icl-rocketry/Ricardo-Pete/Hardware/README.md

# Ricardo-BoardTemplate
Board template including the required components for an ESP32S3 as well as CAN and USB. This is the bare minimum needed for boards in the ricardo ecosystem. To use, place the Ricardo-BoardTemplate folder in your KiCad user templates folder. 
By default, this folder is:
Windows - %USERPROFILE%/Documents/KiCad/6.0/template
