icl-rocketry/Ricardo-Pete/(commit log)

2023-08-17 PCB Done
    [PETE.kicad_pcb, PETE.kicad_sch, power.kicad_sch, pressure-sensor.kicad_sch]
2023-08-19 Review Changes Made (except for meme)
    [PETE.kicad_pcb, PETE.kicad_sch, pressure-sensor.kicad_sch]
2023-08-20 Review Changes
    Still don't know whats going on with the overlapping pours. Meme is a bit rubbish but it'll do for now.
    [PETE.kicad_pcb]
2023-08-23 artem review
    [PETE.kicad_pcb, PETE.kicad_sch]
2023-08-25 forgot name of board + some missed drc
    [PETE.kicad_pcb]
2023-09-14 Pressure Sensor Driver
2023-12-02 updated arduino submodule to corrrect version
